itsashishupadhyay/Wireless_Charging-/(notices)

Notices in the files:
README.md:
License: Research
